leezicai/PixelClock/readme.md

## PixelClock 像素时钟

## 禁止商用

#### 外壳为新设计, 固件程序和PCB均修改自 大聪明的二手脑袋.

### 闲鱼: 小新数码乐园. 欢迎支持. 材料与PCB均兼容原版外壳.

- [闲鱼地址](https://m.tb.cn/h.gHUBSjD?tk=fwsg3jWDiOH)
- 微信小程序闲鱼地址(发送聊天框后点击打开)
  - #小程序://闲鱼/EybCRYfAMwJbfsb

## 目录

### 一 PixelClock像素时钟 展示

### 二 材料和工具

### 三 刷入ESP32-C3固件

### 四 焊接和组装

## 一 PixelClock 像素时钟展示

[PixelClock像素时钟(一) 展示 B站视频](https://www.bilibili.com/video/BV1yrxTeEETV/)

[PixelClock像素时钟(一) 展示.md 文档](Document/PixelClock像素时钟一展示.md)

[PixelClock像素时钟(一) 展示.jpg 图片](Document/PixelClock像素时钟一展示.jpg)

## 二 材料和工具

[PixelClock像素时钟(二) 材料和工具 B站视频](https://www.bilibili.com/video/BV1NT421z7xP/)

[PixelClock像素时钟(二) 材料和工具.md 文档](Document/PixelClock像素时钟二材料和工具.md)

[PixelClock像素时钟(二) 材料和工具.jpg 图片](Document/PixelClock像素时钟二材料和工具.jpg)

## 三 刷入ESP32-C3 固件

[PixelClock像素时钟(三) 刷入ESP32-C3固件 B站视频](https://www.bilibili.com/video/BV1JsxmepETZ/)

[PixelClock像素时钟(三) 写入固件.md 文档](Document/PixelClock像素时钟三写入固件.md)

[PixelClock像素时钟(三) 写入固件.jpg 图片](Document/PixelClock像素时钟三写入固件.jpg)

## 四 焊接和组装

[PixelClock像素时钟(四) 焊接和组装 B站视频](https://www.bilibili.com/video/BV1R22kYeEFm/)

[PixelClock像素时钟(四) 焊接和组装.md 文档](Document/PixelClock像素时钟四焊接和组装.md)

[PixelClock像素时钟(四) 焊接和组装.jpg 图片](Document/PixelClock像素时钟四焊接和组装.jpg)
