leezicai/PixelClock/Document/PixelClock像素时钟一展示.md

# PixelClock像素时钟(一) 展示

## 目录

### 展示完整功能
- 时间显示
	- 时:分:秒
		- 2种时间跳变动画
	- 时:分
		- 鲸鱼动画
	- 月:日
- 拾音
	- 多种配色的拾音界面
- 闹钟功能
	- 闹钟音乐可更换
- 亮度控制2种方式
	- 光线自动感应
	- 自动设置

### 像素时钟外壳特点
- ① 屏幕是4边等宽的微边框
- ② 自带倾斜角度，无须支架
- ③ 按钮从上面移动到后面，正面看更简洁
- ④ 后盖有3种样式可选
	- 默认后盖
	- 圆形后盖
	- 四叶草后盖
- ⑤ 后盖预留光敏电阻位置

### 程序上改进
- ① 时分秒跳动动画改变 
- ② 时钟光线感应, 右侧电源按钮可以跟随光线感应了
- ③ 亮度默认16,最高61, 防止过热

### PCB改进
- 主控PCB
	- 增加光敏电阻电路
	- 增加电源跟随光线变化电路
- 灯板PCB
	- 原来8x8 更改为16x8 方便组装
