leezicai/PixelClock/Document/PixelClock像素时钟一展示.jpg

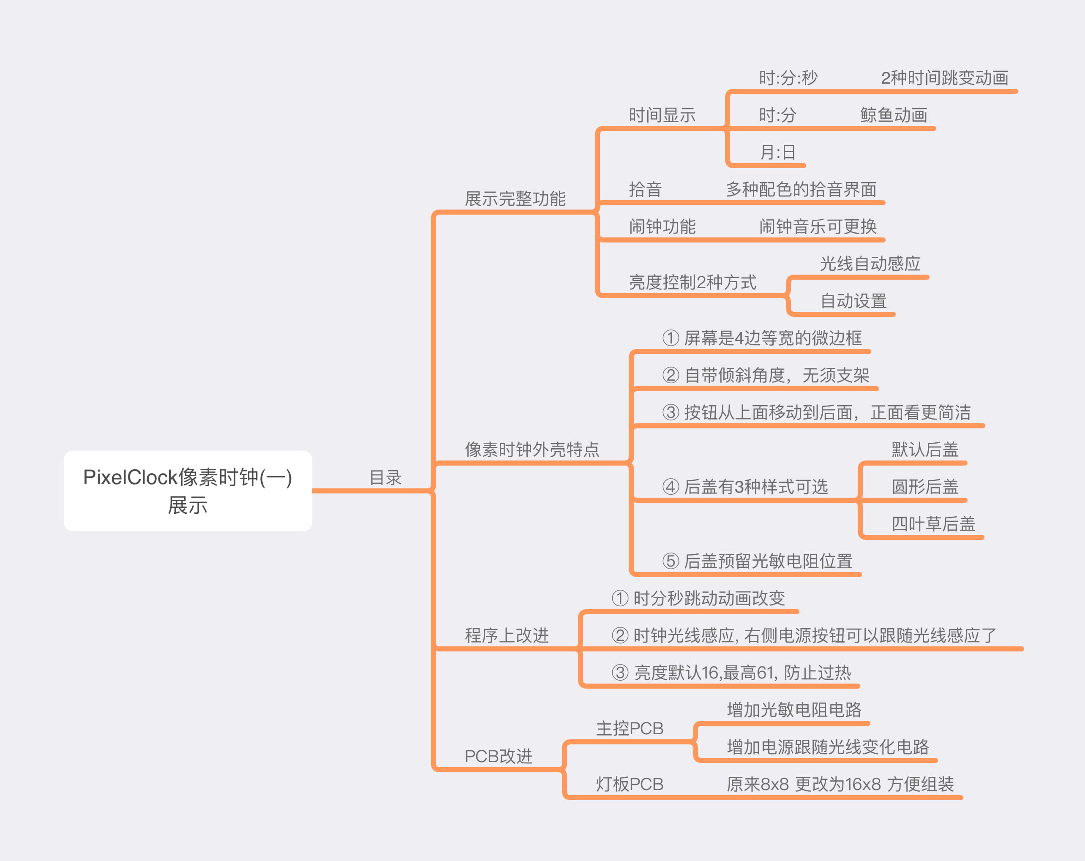
Document/PixelClock像素时钟一展示.jpg
