leezicai/PixelClock/Document/PixelClock像素时钟三写入固件.jpg

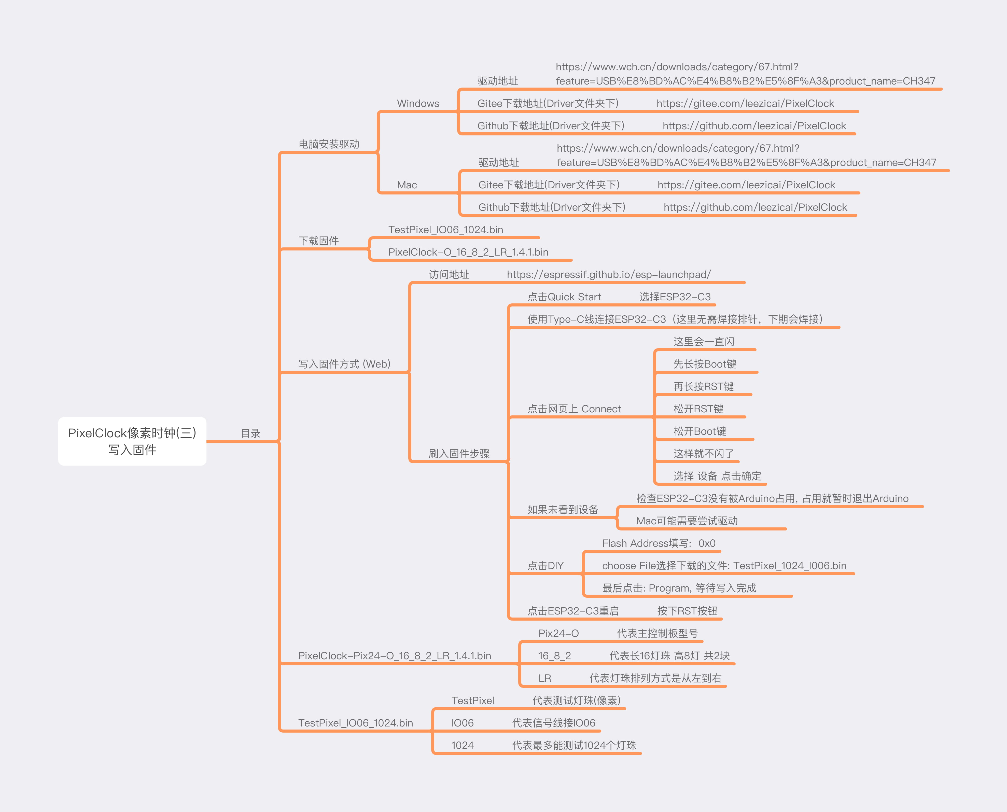
Document/PixelClock像素时钟三写入固件.jpg
