leezicai/PixelClock/Document/PixelClock像素时钟二材料和工具.jpg

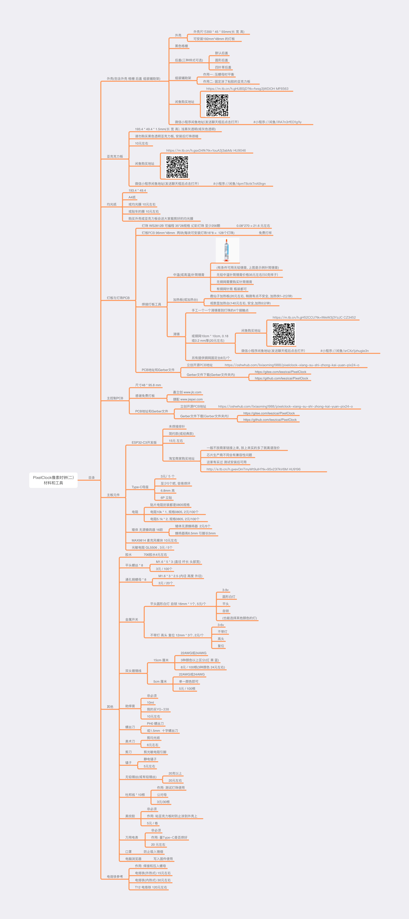
Document/PixelClock像素时钟二材料和工具.jpg
