leezicai/PixelClock/Imags/立创开源地址.png

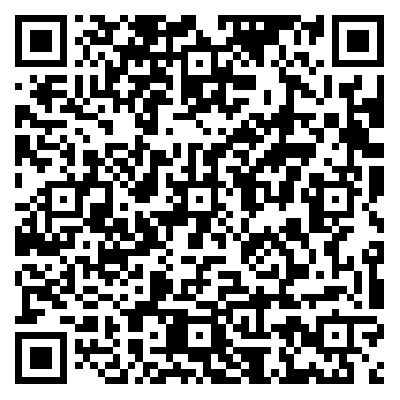
Imags/立创开源地址.png
