leezicai/PixelClock/Imags/闲鱼-全部商品-地址.png

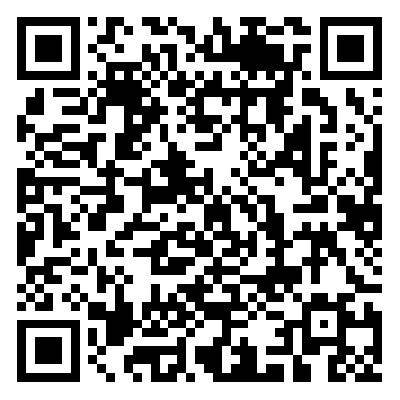
Imags/闲鱼-全部商品-地址.png
