leezicai/PixelClock/(list of files, drawings)

Other design files:
Gerber/PixelClock像素时钟-开源Pix24-O.eprj
