leezicai/PixelClock/Document/PixelClock像素时钟四焊接和组装.jpg

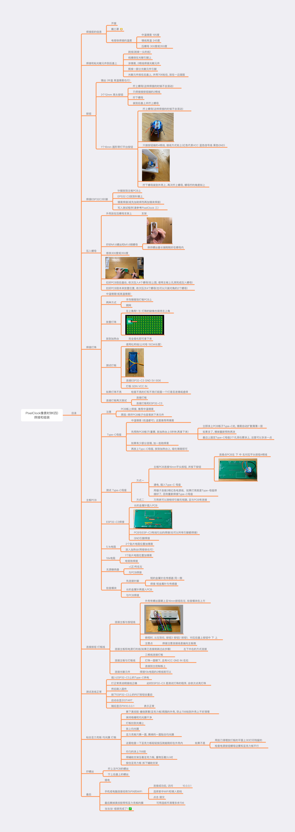
Document/PixelClock像素时钟四焊接和组装.jpg
