leezicai/PixelClock/(commit log)

2024-09-30 更新成markdown说明
2024-09-30 更新 readme.me 链接文案
2024-09-30 PixelClock像素时钟三写入固件.md 中链接增加Https:// 方便跳转
2024-09-30 删除 Document/PixelClock像素时钟- 多个旧的图片
2024-09-30 更新 PixelClock像素时钟四焊接和组装.md
2024-09-30 更新 PixelClock像素时钟四焊接和组装.md 增加压入螺母图
2024-10-07 增加金属按钮规格: 自锁还是复位
2024-10-10 更新PixelClock像素时钟四焊接和组装 和 PixelClock像素时钟二材料和工具添加小程序闲鱼地址
2024-10-10 PixelClock像素时钟四焊接和组装 增加ESP32-C3引脚与主板焊接
2024-10-10 降低图片大小
2024-10-11 更新 PixelClock像素时钟四焊接和组装 示例图
2024-10-12 更新 PixelClock像素时钟二材料和工具.md 增加针筒锡膏示例
2024-10-12 更新 readme.md 增加修改来源 大聪明的二手脑袋
2024-10-12 更新Gerber 文件
2024-10-12 更新 PixelClock像素时钟二材料和工具.md Gerber下载地址, 之前是立创链接发现更新就不可用,更换为Gitee或Github地址, 实时更新
2024-10-12 更新 PixelClock像素时钟二材料和工具.md 增加闲鱼地址
2024-10-12 更新 readme.md 增加 B站视频链接
2024-10-12 更新 readme.md 增加 增加闲鱼地址
2024-10-12 更新 readme.md 增加 增加闲鱼地址 删除二维码
2024-10-12 更新 PixelClock像素时钟三写入固件.md 写固件步骤, 解决插入ESP32-C3 会闪的问题
2024-10-12 增加EasyMatrix 1.4.0 的固件
2024-10-15 更新 PixelClock像素时钟二材料和工具.md 增加Esp32c3 购买地址
2024-10-17 更新 PixelClock像素时钟二材料和工具.md 删除第1个购买链接
